nico-schluter/OpenEDM-arc-generator/README.md

# OpenEDM-arc-generator

## Phos Edition Warning

This fork is a recreation of the OpenEDM Arc Generator, with the goal of making it more accessible and easier to build. The original project is already experimental hardware, and there may be new errors introduced in recreating it.
USE AT YOUR OWN RISK.

## ⚠️ Safety Warning & Disclaimer

THIS PROJECT INVOLVES LETHAL VOLTAGES AND OTHER SERIOUS HAZARDS THAT CAN CAUSE SEVERE INJURY OR DEATH. YOU MUST READ THE FULL [SAFETY WARNING AND DISCLAIMER DOCUMENT](https://github.com/OpenEDM/.github/blob/main/docs/SAFETY_WARNING_AND_DISCLAIMER.md) BEFORE USING ANY PROJECT FILES. BY PROCEEDING, YOU ACKNOWLEDGE AND ACCEPT ALL RISKS AND AGREE TO USE THIS PROJECT ENTIRELY AT YOUR OWN RESPONSIBILITY.

## Main Specifications

<div align="center">

| Parameter | V1 | V2 |
| --- | --- | --- |
| Input voltage (DC) | max. 150V | 48V |
| Input power | max. 200W | max. 300W |
| Arc current (peak) | adjustable, max. 30A | adjustable, max. 30A  |
| Ignition voltage | fixed (same as the input voltage), max. 150V | adjustable, max. 175V |

</div>

## Hardware Versions

- **[V2.0]**. Status: put on hold due to some issues identified during simulation. Details are already available on Discord, and will be posted here later.



- **[V1.2]**. Status: preparing for testing.



- **[V1.1]**. Status: tested, all files except the PCB design are released and available [here](https://github.com/OpenEDM/OpenEDM-arc-generator/blob/main/V1.1/README.md).



## Project Logs on YouTube (V1.1 design)

(https://www.youtube.com/@OpenEDM)
